eballo/word-clock/docs/release.md

# Releases

| Version | Date | Description |
|---|---|---|
| v0.12.0 | 2026-10-25 | Feature/matrix v2 |
| v0.11.0 | 2026-10-25 | Matrix: rotate and mirror options |
| v0.10.0 | 2026-10-24 | Matrix show: texts for the day and week, drawings and personal texts |
| v0.9.0 | 2026-10-24 | Add a 10x6 mini matrix for the 30 LEDs/metre strip |
| v0.8.0 | 2026-10-22 | Add parametric enclosure for the IKEA SANNAHED frame |
| v0.7.0 | 2026-10-21 | Bump the github-actions group with 2 updates |
| v0.6.1 | 2026-10-21 | Refresh locked dependencies and add Dependabot config |
| v0.6.0 | 2026-04-26 | [#19] Cleaning the house |
| v0.5.0 | 2026-04-26 | [#17] Extract configuration into json |
| v0.4.1 | 2026-04-26 | Fix move assets to docs |
| v0.4.0 | 2026-04-25 | [#11] Add spanish and catalan layout initial version |
| v0.3.2 | 2026-04-25 | Fix missing versions + add releases to README |
| v0.3.1 | 2026-04-25 | fix release issue |
| v0.3.0 | 2026-04-25 | [#7] fix release |
| v0.2.0 | 2026-04-25 | Initial python version |
| v0.1.0  | 2026-04-25 | Initial version |
