eballo/word-clock/docs/07-mini-matrix.md

# 07 — Mini Matrix

## Overview

A quick 10 × 6 LED matrix built before the word clock, with the 2 m
Tremex WS2812B strip (30 LEDs/metre, 60 LEDs) already at hand. Every cell
sits over one LED, so the matrix uses the whole strip. It runs the same
scene software the big clock will use (scrolling text, time, IP address,
animations) and tests the Raspberry Pi, the wiring and the printed
grid-and-face design on a small scale. This doc covers the parts, cutting
and wiring the strip, printing the enclosure, assembly and the software.

---

## 1. Parts

| Part | Quantity | Note |
|---|---|---|
| Tremex WS2812B strip, 30 LEDs/metre, 2 m | 1 | Cut into 6 pieces of 10 LEDs |
| Raspberry Pi 3B with microSD card | 1 | Set up as in [03 — Software](03-software.md), Wi-Fi and SSH on |
| 5V power supply, 3 A or more, 5.5 × 2.1 mm plug | 1 | Powers the strip and the Pi: the only cable; the 5V 10 A supply of the bench test is fine |
| Micro-USB plug with screw terminals (USB-C on a 4B) | 1 | Powers the Pi from the same supply, inside the box |
| 1000 µF 16 V electrolytic capacitor | 1 | Across 5V and GND at the strip input |
| 220 Ω resistor | 1 | In the data line (Freenove kit) |
| Rectifier diode | 1 | Only if the 3,3V data is not read reliably (Freenove kit) |
| Wire, 22 AWG, three colours | about 1 m | 5 joints between rows, about 6 cm each |
| M3 × 16 mm bolt and nut | 2 | Join the two grid halves |
| M2.5 × 6 mm self-tapping screw | 4 | Fix the Raspberry Pi in the stand box |
| Panel-mount DC jack, 5.5 × 2.1 mm (DC-022, 11 mm hole) | 1 | Power input in the back of the stand box |
| Lever connectors (Wago 221), 3-way | 2 | 5V and GND joints inside the box |
| Tracing paper | 1 A3 sheet | Diffuser between the face and the grid |
| PLA, white | about 150 g | Light grid |
| PLA, black | about 250 g | Front face and stand box |

---

## 2. Dimensions

```
                 35,7 cm
┌──────────────────────────────────────┐
│  margin 1,2 cm (wires between rows)  │
│ ┌──────────────────────────────────┐ │
│ │ 10 × 6 cells, 3,33 cm pitch      │ │ 22,4 cm
│ │ matrix 33,3 × 20,0 cm            │ │
│ └──────────────────────────────────┘ │
│                                      │
└──────────────────────────────────────┘
        left half │ right half   (split after column 5)
```

| Measurement | Value |
|---|---|
| Cell pitch | 3,33 cm (one LED of a 30 LEDs/metre strip) |
| Matrix | 33,3 × 20,0 cm |
| Grid panel | 35,7 × 22,4 cm |
| Face (with its skirt) | 36,1 × 22,8 cm |
| Depth | about 2,6 cm (2 mm back plate, 22 mm walls, paper, 2 mm face), plus 4,0 cm of stand box |
| Printed halves | Grid 17,9 × 22,4 cm, face 18,1 × 22,8 cm: each fits the 25,6 cm bed of the Bambu Lab A1 |
| Stand box | 14,3 × 18,4 × 4,0 cm, centred behind the matrix, down to its bottom edge |
| Tilt on the table | 15° backwards |
| Face windows | 3,03 × 3,03 cm, 3 mm bars |

---

## 3. Layer stack

```
   viewer
     │
     ▼
┌──────────────────────────────┐  face, black PLA, 2 mm, one window per cell
│ ▓▓  ▓▓  ▓▓  ▓▓  ▓▓  ▓▓  ▓▓   │  skirt (6 mm) hugs the grid outer wall
├──────────────────────────────┤  tracing paper
│ │    │    │    │    │    │   │  light grid, white PLA, 22 mm walls
│ │ ●  │ ●  │ ●  │ ●  │ ●  │ ● │  one WS2812B LED per cell
└──────────────────────────────┘  back plate 2 mm, strip stuck on it
        ┌──────────────┐          stand box, 40 mm: Raspberry Pi, DC jack,
        │  Pi   ▣ jack │          wiring
        └──────────────┘
```

The strip runs along the centre of every row, under the column walls
through 13 mm notches. The ends of each row come out into the margin,
where the wires that join the rows run.

The strip input wires also run in the margin, hidden behind the face
border: from the start of row 0 up the left margin, then along the top
margin to a 14 × 6 mm hole in the back plate. The hole sits behind the
stand box, so the wires go straight into it.

```
   front view, left half, top-left corner

   ┌───────────────────────────────────────── outer wall
   │  ═══════════════════════▣  ← 14 × 6 mm hole, behind the box
   │ ║┌──────┬──────┬──────┬──────┬───
   │ ║│ ━━━━━━━━━━━━━━━━━━━━━━━━━━━━━━ row 0 strip, DIN on the left
   │ ║┼──────┼──────┼──────┼──────┼───
   │ ║ wires in the margin
```

---

## 4. Stand box

The box on the back is also the stand. Its base is cut at 15°, so the
matrix stands on a table leaning back, on the bottom edge of the grid and
the base of the box. It hides the Raspberry Pi and the wiring: only the
power cable comes out, from the back.

The box slides onto the grid, without screws or clips. Four pins on
columns of the box have a wide conical head. They go through the wide end
of four keyhole slots in the grid back plate, at cell corners hidden
behind the face bars, and the box slides 8 mm down. The heads then hold
the box against the back plate, and the cones pull it tight.

```
   keyhole slot (front view)        pin of the box (side view)

        ╭───╮                           ▄███▄  head Ø8, cone under it
        │   │  ← head goes in here        ▀█▀
        ╰┐ ┌╯                          ════█════  grid back plate (2 mm)
         │ │                               █
         │ │  ← box slides 8 mm down       █    column Ø10
         ╰─╯     and stays locked       ▀▀▀▀▀▀▀  floor of the stand box
```

Gravity keeps the box locked when you lift the matrix, and on the table
the base of the box and the bottom edge of the grid both rest on the
table, so the box cannot slide up. To take it off, lay the matrix face
down, slide the box 8 mm up and lift it.

```
   side view, standing on the table (front on the left)

          face  grid
              ╱   ╱
             ╱   ╱━━━━╱
            ╱   ╱    ╱   stand box, Raspberry Pi inside
           ╱   ╱    ◯━━ power cable
          ╱   ╱    ╱
   ══════╱═══╱━━━━╱═════  table: flat base of the box
          15° lean back
```

```
          seen from the back

   ┌───────────────────────────────────┐  ← top edge of the grid
   │                 ║║║║║║║  vents  ▣  │  ▣ strip wires from the
   │ ◉                              ◉  │    cable hole (inside)
   │                                   │
   │        ┌──────────────────┐       │
   │        │  Raspberry Pi 3B │       │
   │        │   (vents behind) │       │
   │        └──────────────────┘       │
   │ ◉                              ◉  │
   │                         ◯ DC jack │
   │      plug and wiring room         │
   └───────────────────────────────────┘
   ▔▔▔▔▔▔▔▔▔▔▔▔ base on the table ▔▔▔▔▔▔▔▔
```

The view is from the back, so the Pi sits on the left here and on the
right in the model, which uses front-view coordinates.

| Opening | Where | For |
|---|---|-----|
| DC jack, 11 mm | Back, low | The 5V supply: the only cable |
| Cable hole, 14 × 6 mm | Grid back plate, top margin, inside the box | Strip input wires, never outside |
| Vents | Back under the Pi, and top wall | Air for the Raspberry Pi |

There is no opening for the USB, Ethernet or HDMI ports: use the Pi over
Wi-Fi and SSH. The microSD card faces into the box, so take the box off
(slide it up and lift it) to change it.

To make the matrix stand steeper or flatter, change `tilt`; a deeper box
(`box_d`) gives a longer base and a steadier stand.

Inside the box:

```
 DC jack + ──► Wago 5V ──┬──────────────────► strip 5V (red)
                         ├──[1000 µF]──┐
                         └──────────────────► micro-USB plug + ──► Pi power
 DC jack − ──► Wago GND ─┴─────────────┴────► strip GND (white)
                         └──────────────────► micro-USB plug − 
 Pi GPIO 18 (pin 12) ──[220 Ω]──────────────► strip DIN (green)
```

The Pi takes its power through its own micro-USB port, from the same
supply, so it keeps its input protection. The micro-USB cable also joins
the Pi GND to the strip GND. Hold the Wago connectors and the capacitor
with double-sided tape.

---

## 5. Print the enclosure

```bash
uv run wordclock-cad --matrix    # STL files in build/stl/matrix/
```

It writes three Bambu Studio projects, one part per plate:

| Project | Parts | Filament | Orientation |
|---|---|---|---|
| `build/bambu/matrix_grid.3mf` | `grid_left`, `grid_right` | White PLA, 3 walls, 15 % infill | Back plate on the bed |
| `build/bambu/matrix_face.3mf` | `face_left`, `face_right` | Black PLA, 100 % infill | Front on the bed, skirt up |
| `build/bambu/matrix_box.3mf` | `box` | Black PLA, 3 walls, 15 % infill | Floor on the bed |

To change a size, edit the parameters at the top of
`wordclock/cad/matrix.scad` (wall height, margin, notch width, box depth,
jack hole) and render
again. Open the file in the OpenSCAD GUI to see the assembly.

---

## 6. Cut and wire the strip

### 6.1 Snake layout

LED 0 is in the top-left cell. Even rows run left to right, odd rows right
to left, so each row joins the next at alternating ends.

```
 DIN ──► [ 0  1  2  3  4  5  6  7  8  9] ─┐   row 0
      ┌─ [19 18 17 16 15 14 13 12 11 10] ◄┘   row 1
      └► [20 21 22 23 24 25 26 27 28 29] ─┐   row 2
      ┌─ [39 38 37 36 35 34 33 32 31 30] ◄┘   row 3
      └► [40 41 42 43 44 45 46 47 48 49] ─┐   row 4
         [59 58 57 56 55 54 53 52 51 50] ◄┘   row 5
```

### 6.2 Steps

1. Check the arrows printed on the strip: they point away from DIN. Start
   from the DIN end.
2. Cut 6 pieces of 10 LEDs (33,3 cm each) on the copper cut marks.
3. Stick each piece along the centre of its row, through the wall notches,
   arrows pointing in the direction of the row (right on rows 0, 2 and 4,
   left on rows 1, 3 and 5).
4. Solder three wires (5V, data, GND) from the DOUT end of each row to the
   DIN end of the next one, in the side margin. Keep the colours the same
   on every joint.
5. Solder the input wires to the DIN end of row 0, about 40 cm long. Run
   them up the left margin and along the top margin, and pass them through
   the 14 × 6 mm hole in the back plate of the left half.

> ⚠️ Data goes from DOUT to DIN only. A row stuck the wrong way round stays
> dark, and so does every row after it.

### 6.3 Connection to the Raspberry Pi

Test first on the breadboard, as in the bench test ([06 — Bench Test](06-bench-test.md), section 2),
then move the wiring into the stand box (section 4):

| From | To | Note |
|---|----|---|
| Pi GPIO 18 (pin 12) | 220 Ω resistor → strip DIN | Data line |
| Supply + | Strip 5V and micro-USB plug + | Never to the Pi GPIO pins |
| Supply − | Strip GND and micro-USB plug − | Common ground through the micro-USB cable |
| 1000 µF capacitor | Between strip 5V and GND, at the input | Stripe (negative) to GND |

60 LEDs draw up to 3,6 A in full white. The software dims any frame that
would draw more than 1,5 A (`MATRIX_MAX_MA` in `wordclock/config.py`); with
the Pi 3B (up to about 1,2 A) that needs a 3 A supply at least. If the
colours flicker, use the diode trick from the bench test.

### 6.4 Quick test powered from the Raspberry Pi

To try the strip before the 5V supply arrives, power it from the Pi's own
5V pin, with only the Pi's power cable plugged in.

```
 Raspberry Pi 3B
   pin 2  (5V) ─────────────────────► strip 5V (red)
   pin 6  (GND) ────────────────────► strip GND (white)
   pin 12 (GPIO 18) ──[220 Ω]───────► strip DIN (green)
```

The Pi 3B supply gives 2,5 A, the Pi uses 0,5–1 A of it, and the
micro-USB input has a fuse of about 2,5 A. That leaves about 1 A for the
LEDs, so keep the software limit low:

```bash
sudo .venv/bin/wordclock-matrix wiring --brightness 30 --max-ma 600
sudo .venv/bin/wordclock-matrix rainbow --brightness 30 --max-ma 600
```

| Symptom | Fix |
|---|-----|
| The Pi reboots, or shows the under-voltage warning | Lower `--max-ma`; `vcgencmd get_throttled` must print `throttled=0x0` |
| Random colours or flicker | Put the rectifier diode between pin 2 and the strip 5V, stripe towards the strip |

> ⚠️ Never run without `--max-ma`: 60 LEDs in full white draw 3,6 A and
> would reset the Pi. Do not connect or disconnect the strip while the Pi
> is on.

For the finished matrix, use the DC jack of the stand box (section 4): it
powers the strip and the Pi together without going through the Pi's fuse,
so the limit can stay at 1,5 A.

---

## 7. Assemble

1. Bolt the two grid halves together with the two M3 bolts, one in the
   top margin and one in the bottom margin. The stand box pins sit in both
   halves, so the box also holds the middle of the seam.
2. Stick the strip rows and solder the joints (section 6).
3. Screw the Raspberry Pi into the stand box (four M2.5 screws) and fit
   the DC jack in the back.
4. Wire the strip input wires, which come out of the cable hole, inside
   the box (section 4). Leave about 2 cm of slack for the 8 mm slide.
5. Lay the matrix face down. Put the four pin heads into the wide ends of
   the keyhole slots and slide the box 8 mm down, towards the bottom edge,
   until its base lines up with the bottom of the grid.
6. Run the `wiring` scene (section 8) and check that the cells light in
   order before closing.
7. Lay the tracing paper over the grid, cut to the outer edge of the walls.
8. Press the two face halves onto the grid: the skirt hugs the outer wall.
9. Stand the matrix on the table and plug in the power cable.

---

## 8. Software

The matrix uses the `wordclock-matrix` command. On the Mac, `--mock` draws
the matrix in the terminal instead of lighting LEDs:

```bash
uv run wordclock-matrix --mock show
uv run wordclock-matrix --mock text --text "Hola!"
uv run wordclock-matrix --mock rain
uv run wordclock-matrix --mock clock --color ff8800
```

On the Raspberry Pi, after `uv sync --extra rpi` ([03 — Software](03-software.md)):

```bash
cd ~/word-clock
sudo .venv/bin/wordclock-matrix wiring          # cells one by one: checks the snake
sudo .venv/bin/wordclock-matrix rainbow         # colour order and every LED
sudo .venv/bin/wordclock-matrix ip              # IP address of the Pi
sudo .venv/bin/wordclock-matrix text --text "Bon dia" --preview
```

| Scene | What it shows |
|---|---|
| `show` | The default: every scene in turn, with new colours each time (section 9) |
| `text` | Scrolling text (`--text`), 3 × 5 pixel font on the bottom five rows, accents folded (`à` → `A`) |
| `clock` | The time as `HH:MM`, scrolling |
| `ip` | The local IP address, scrolling |
| `rain` | Green drops with fading trails, like Matrix rain |
| `rainbow` | A rainbow sliding diagonally |
| `sparkle` | Cells that light up in random colours and fade out |
| `wiring` | One cell at a time, in order, to test the wiring |

| Option | Default | Use |
|---|---|-----|
| `--brightness` | 40 | Global brightness, 0–255 |
| `--color` | per scene | Hex colour, e.g. `ff8800` |
| `--max-ma` | 1500 | Software current limit in mA |
| `--seconds` | none | Stop after this time |
| `--no-snake` | | Every row wired left to right |
| `--preview` | with `--mock` | Also draw the matrix in the terminal |

The scenes draw on a cell canvas of any size (`--width`, `--height`), so
the same code runs on the 16 × 16 word clock later.

---

## 9. Start the show on boot

The `show` scene plays on its own, without a keyboard or a network. It
starts with the IP address once, then repeats forever:

```
   IP ──► clock ──► text ──► effect ──► clock ──► text ──► drawing ──► …
          HH:MM                rainbow,                     heart, smile,
                               rain or sparkles             ZZZ at night
```

| Part | Content | Time |
|---|---|---|
| Clock | `HH:MM`, a random colour or rainbow letters | One pass across the matrix |
| Text | One text that fits the moment (table below), or a personal one | One pass across the matrix |
| Effect | `rainbow` at a random speed, `rain` in a random colour, or `sparkle` | 15 s |
| Drawing | A red heart or a smile; `ZZZ` from 23:00 to 06:59. It pulses like a heartbeat | 6 s |

Every scene fades in and out over 0,5 s.

| Text | When |
|---|---|
| `BON DIA` / `BONA TARDA` / `BONA NIT` | 06–13 h / 13–20 h / 20–06 h |
| `24 OCT` | Always |
| `FALTEN 3 DIES PER DIVENDRES`, `DEMÀ ÉS DIVENDRES!` | Monday to Thursday |
| `BON CAP DE SETMANA!` | Friday from 15:00 |
| `BON DISSABTE`, `BON DIUMENGE` | Weekend |
| `HORA DE DINAR` / `HORA DE SOPAR` | 13–15 h / 20–22 h |
| `A DORMIR!` | 23:00 to 06:59 |

### Personal texts

Names and dates stay out of the public repository, in `matrix.toml` next
to the code on the Pi (`~/word-clock/matrix.toml`, ignored by git). The
show mixes the messages with the texts above. On a date of the list, half
of the texts are that date's own.

```toml
# Shown any day
messages = ["HOLA ENRIC", "♥ CASA ♥"]

# Shown on one day of every year, "MM-DD"
[dates]
"03-14" = "FELICITATS ANNA!"
"12-25" = ["BON NADAL!", "♥ ♥ ♥"]
```

The show reads the file when it starts: restart the service after editing
it. A missing or broken file only leaves the personal texts out
(`journalctl` says why). `--config` reads another file.

A systemd service starts the show when the Pi boots. Create it on the Pi:

```bash
sudo nano /etc/systemd/system/wordclock-matrix.service
```

```ini
[Unit]
Description=Mini LED matrix show
Wants=network-online.target
After=network-online.target

[Service]
Type=simple
User=root
WorkingDirectory=/home/eballo/word-clock
ExecStart=/home/eballo/word-clock/.venv/bin/wordclock-matrix show
Restart=on-failure
RestartSec=5

[Install]
WantedBy=multi-user.target
```

Replace `/home/eballo` with your user's home directory. Enable and start
it:

```bash
sudo systemctl daemon-reload
sudo systemctl enable --now wordclock-matrix
sudo systemctl status wordclock-matrix
```

| Command | Use |
|---|-----|
| `sudo systemctl stop wordclock-matrix` | Stop the show and turn the LEDs off, e.g. to run another scene by hand |
| `sudo systemctl start wordclock-matrix` | Start it again |
| `sudo systemctl disable wordclock-matrix` | Do not start it on boot any more |
| `journalctl -u wordclock-matrix -f` | Follow its log |

> ⚠️ Stop the service before running `wordclock-matrix` by hand: two
> programs driving GPIO 18 at once garble the strip.

---

## 10. Build checklist

- [ ] Grid halves, face halves and stand box printed (`uv run wordclock-cad --matrix`)
- [ ] Grid halves bolted together with two M3 × 16 mm bolts
- [ ] Raspberry Pi and DC jack fitted in the stand box, box slid onto the grid
- [ ] Strip cut into 6 pieces of 10 LEDs, stuck in a snake, arrows checked
- [ ] Five row joints soldered, input wires along the margins and through the hole behind the box
- [ ] Quick test powered from the Pi (section 6.4): `wiring` scene with `--max-ma 600`
- [ ] Safety check of [06 — Bench Test](06-bench-test.md) done before powering up
- [ ] `wiring` scene lights the 60 cells in order
- [ ] `rainbow` scene shows the right colours
- [ ] Tracing paper and face fitted
- [ ] `text`, `clock`, `ip` and `rain` scenes running
- [ ] `wordclock-matrix` service enabled: the show starts when the matrix is plugged in
- [ ] Matrix standing on the table, only the power cable showing
