eballo/word-clock/(commit log)

2021-05-02 initial commit - prototype
2026-04-25 Merge pull request #4 from eballo/create_initial_version
    Create initial version
    [.bumpversion.cfg]
2026-04-25 [#5] add release notes (#6)
    [.bumpversion.cfg]
2026-04-25 [#7] fix release (#8)
    [.bumpversion.cfg]
2026-04-26 [#19] Cleaning the house (#23)
    [.bumpversion.cfg]
2026-10-22 Add parametric enclosure for the IKEA SANNAHED frame (#26)
    * Add parametric enclosure for the IKEA SANNAHED frame
    The 16x16 matrix no longer fits a 30 LEDs/metre strip in the 48.5 cm
    inner opening, so the clock moves to a 3.0 cm pitch with 12 mm bullet
    pixels held by a printed light grid.
    - OpenSCAD model for face, letter fill, diffuser, light grid and
    Raspberry Pi Zero 2 W box, split into 2x2 tiles for the Bambu Lab A1
    - wordclock-cad CLI that renders every STL per language
    - New 05-enclosure doc and updated hardware and assembly docs
    * Add assembly preview for the OpenSCAD GUI
2026-10-24 Stencil face, 144 LEDs/metre strip grid and screen module (#27)
    * Use Karla Bold Stencil letters and dovetail-joined face tiles
    The face is now a single black print with stencil letter holes and a
    tracing paper diffuser, so only the face changes per language. Face
    tiles lock together with dovetail tabs placed where four cells meet.
    * Hang the Raspberry Pi box under the frame with a push button
    The box bolts to the back board through a hanger plate, keeps the frame
    flat against the wall, and opens from underneath. It adds a 12 mm push
    button on the front and a DC jack on the side.
    * Add a camera to the Raspberry Pi box
    The box now holds a Camera Module 3 behind a lens hole in the front.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
2026-10-24 Add a 10x6 mini matrix for the 30 LEDs/metre strip (#28)
    * Add a 10x6 mini matrix for the 30 LEDs/metre strip
    Scene software (cell canvas, pixel font, text, clock, IP, rain, rainbow
    and wiring scenes) behind the wordclock-matrix command, a two-half
    enclosure rendered with wordclock-cad --matrix, and the build guide.
    * Add a back box for the Raspberry Pi and the wiring
    The box screws onto four bosses on the grid back plate and hangs the
    matrix on the wall through two keyholes. It has openings for the Pi
    power and USB ports, a panel-mount DC jack, an optional push button,
    the strip wires and ventilation.
    * Turn the back box into a table stand with a single power cable
    The box now reaches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
2026-10-25 Matrix: rotate and mirror options (#31)
    * Add rotate and mirror options for a matrix mounted the other way round
    * Sync uv.lock with version 0.10.0
    * Note when to rotate the matrix in the boot service
2026-10-25 Feature/matrix v2 (#32)
    * Matrix v2: wider margins, box pins in the margins, click-in Pi with a port window
    * Compact stand box for a table or a wall, pins on the row lines
    * Matrix in three click-in layers: tray, grid and face with rivets and a camera window
    * Move the camera to the bottom margin, next to the cable hole
    * Hide a tactile switch behind a printed rivet button
    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
